Hyperion13-cmd/GaN-FET-Synchronous-Buck/Simulation/TERS_POLARİTE_TEST.asc

D1: zener; BZX84C15L
M1: pmos; SQJ469EP
R1: res; 100k
R2: res; 10
V1: voltage; 30V
Named nets: 0
.tran 10m
