Hyperion13-cmd/GaN-FET-Synchronous-Buck/(list of files, drawings)

Other design files:
Hardware_Files/senkron_buck.PcbDoc
Hardware_Files/Senkron_Buck.PrjPcb
Hardware_Files/Senkron_buck.SchDoc
